CopycatMusic/ComposerMIDICV/docs/pictures/Composer_MIDI_CV_Panel_Silkscreen.png

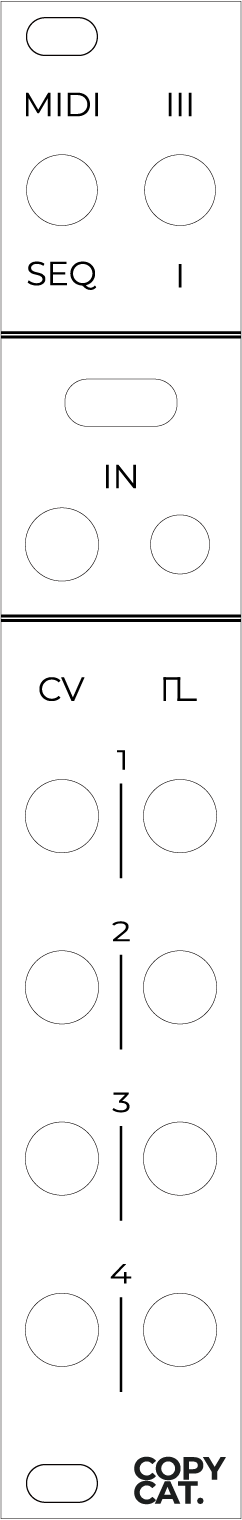
docs/pictures/Composer_MIDI_CV_Panel_Silkscreen.png
