CopycatMusic/ComposerMIDICV/docs/pictures/ComposerBack.png

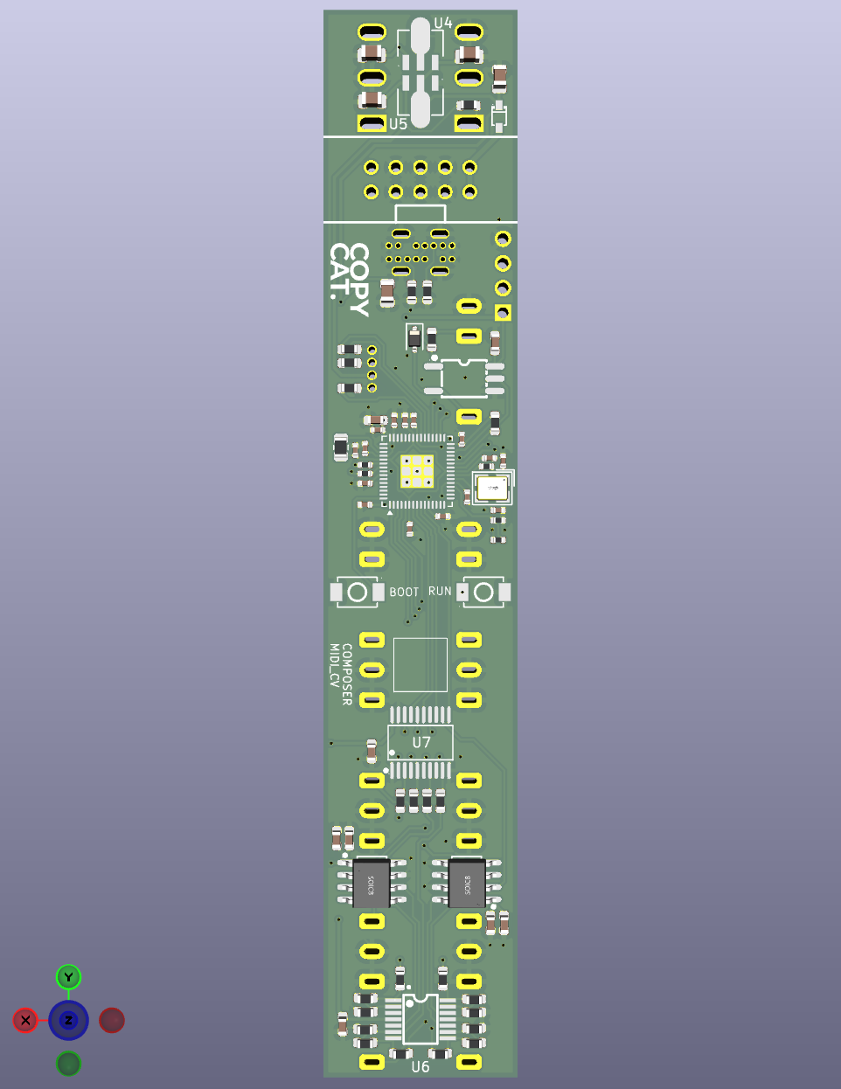
docs/pictures/ComposerBack.png
