CopycatMusic/ComposerMIDICV/hardware/v0.2.1/BOM_V0.2.1_v0.2_1.csv

No. | Quantity | Comment | Designator | Footprint | Value | Manufacturer Part | Manufacturer | Supplier Part | Supplier
1 | 2 | 10uF | C1,C2 | C0805 | 10uF | CL21A106KAYNNNE | SAMSUNG(三星) | C15850 | LCSC
2 | 2 | 15pF | C3,C17 | C0603 | 15pF | CL10C150JB8NNNC | SAMSUNG(三星) | C1644 | LCSC
3 | 15 | 100nF | C4,C5,C6,C7,C10,C11,C12,C13,C15,C16,C19,C20,C21,C22,C24 | C0402 | 100nF | CL05B104KB54PNC | SAMSUNG(三星) | C307331 | LCSC
4 | 3 | 4.7uF | C8,C18,C23 | C0402 | 4.7uF | CL05A475MP5NRNC | SAMSUNG(三星) | C23733 | LCSC
5 | 1 | PH2.54-01-04PZD | H1 | HDR-TH_4P-P2.54-V-M-1 |  | PH2.54-01-04PZD | XUNPU(讯普) | C7501582 | LCSC
6 | 8 | PJ3001F | J1,J2,J3,J4,J5,J6,J7,J8 | AudioJack_3.5mm |  |  | Tayda Electronics
7 | 1 | 3.3uH | L1 | IND-SMD_L2.0-W1.6_AOTA-B201610S3R3-101-T | 3.3uH | AOTA-B201610S3R3-101-T | ABRACON | C42411119 | LCSC
8 | 2 | 5.1kΩ | R1,R2 | R0402 | 5.1kΩ | 0402WGF5101TCE | UNI-ROYAL(厚声) | C25905 | LCSC
9 | 8 | 10kΩ | R3,R18,R19,R20,R22,R23,R24,R25 | R0402 | 10kΩ | 0402WGF1002TCE | UNI-ROYAL(厚声) | C25744 | LCSC
10 | 3 | 33Ω | R4,R5,R17 | R0402 | 33Ω | 0402WGF330JTCE | UNI-ROYAL(厚声) | C25105 | LCSC
11 | 9 | 1kΩ | R6,R7,R8,R9,R10,R11,R12,R13,R16 | R0603 | 1kΩ | 0603WAF1001T5E | UNI-ROYAL(厚声) | C21190 | LCSC
12 | 2 | 470Ω | R14,R15 | R0603 | 470Ω | 0603WAF4700T5E | UNI-ROYAL(厚声) | C23179 | LCSC
13 | 1 | 1kΩ | R21 | R0402 | 1kΩ | 0402WGF1001TCE | UNI-ROYAL(厚声) | C11702 | LCSC
14 | 2 | TS-1088-AR02016 | SW1,SW3 | SW-SMD_L3.9-W3.0-P4.45 |  | TS-1088-AR02016 | XUNPU(讯普) | C720477 | LCSC
15 | 1 | RS-07 300±150gf | SW2 | RS16-Rotary-Switches
16 | 1 | NCP1117ST33T3G | U1 | SOT-223-3_L6.5-W3.4-P2.30-LS7.0-BR |  | NCP1117ST33T3G | onsemi(安森美) | C26537 | LCSC
17 | 1 | TYPE-C 14PLC-H10.0 | U2 | USB-C-TH_SHOUHAN_TYPE-C-14PLC-H10.0 |  | TYPE-C 14PLC-H10.0 | SHOU HAN(首韩) | C3151746 | LCSC
18 | 1 | RP2354A | U3 | QFN-60_L7.0-W7.0-P0.40-TL-EP3.4 |  | RP2354A | Raspberry Pi(树莓派) | C41378174 | LCSC
19 | 1 | 12MHz | U4 | CRYSTAL-SMD_4P-L3.2-W2.5-BL | 12MHz | ABM8-272-T3 | ABRACON | C20625731 | LCSC
20 | 2 | MCP4822-E/SN | U5,U6 | SOIC-8_L4.9-W3.9-P1.27-LS6.0-BL |  | MCP4822-E/SN | MICROCHIP(美国微芯) | C16040 | LCSC
21 | 1 | 74AHCT244PW | U7 | TSSOP-20_L6.5-W4.4-P0.65-LS6.4-BL |  | 74AHCT244PW | MDD(辰达半导体) | C54815894 | LCSC
22 | 1 | TLV9064IPWR | U8 | TSSOP-14_L5.0-W4.4-P0.65-LS6.4-BL |  | TLV9064IPWR | TI(德州仪器) | C779410 | LCSC
23 | 1 | TJ-L5FPTXHMCYLCRGB-A5 | U9 | LED-TH_4P-BD5.8-P1.30 |  | TJ-L5FPTXHMCYLCRGB-A5 | TOGIALED(统佳) | C20613339 | LCSC
