CopycatMusic/ComposerMIDICV/hardware/ComposerMIDICV/production/COMPOSERv1.0_bom.csv

Designator | Footprint | Quantity | Value | LCSC Part #
C1 | C_0805 | 1 | 1uF | C28323
C10, C11, C12, C13, C14, C15, C2, C5, C6, C7, C8, C9 | C_0402 | 12 | 100nF | C1525
C16, C21 | C_0805 | 2 | 10uF | C15850
C17 | C_0402 | 1 | 4.7uF | C23733
C18, C26, C29, C31, C33 | C_0603 | 5 | 100nF | C14663
C19 | C_0805 | 1 | 4.7uF | C1779
C20 | C_0805 | 1 | 100nF | C28233
C27, C28 | C_0603 | 2 | 10uF | C96446
C3, C4 | C_0402 | 2 | 15pF | C1548
C32 | C_0603 | 1 | 4.7uF | C19666
D1 | SOD-323_L1.8-W1.3-LS2.5-RD | 1 | 1N5819WS | C191023
D2 | D_SOD-323 | 1 | 1N4148WS | C2128
H1 | HDR-TH_4P-P2.54-V-M-1 | 1 | PH2.54-01-04PZD | C7501582
J1, J2, J3, J4, J5, J6, J7, J8 | Jack_3.5mm_QingPu_WQP-PJ301M-12_Vertical | 8 | AudioJack2_SwitchT
J9 | Jack_3.5mm_QingPu_WQP-PJ366ST_Vertical | 1 | AudioJack3
L3 | 0805 | 1 | 3.3uH | AOTA-B201610S3R3-101-T
P1 | IDC-TH_10P-P2.54_C5665 | 1 | HDR-IDC-2.54-2X5P | C5665
R1 | R_0402 | 1 | 1kΩ | C11702
R10, R11, R12, R13, R14, R15, R16, R17, R8, R9 | R_0603 | 10 | 1kΩ | C21190
R18 | R_0603 | 1 | 220Ω | C22962
R19, R20 | R_0402 | 2 | 100kΩ | C25741
R2, R3 | R_0402 | 2 | 33Ω | C25105
R21, R22, R23, R24, R25, R26, R27, R28, R29, R7 | R_0603 | 10 | 10kΩ | C25804
R4 | R_0603 | 1 | 470Ω | C23179
R5, R6 | R_0603 | 2 | 5.1kΩ | C23186
SW1, SW2 | SW-SMD_L3.9-W3.0-P4.45 | 2 | TS-1088-AR02016 | C720477
SW3 | SW-TH_MT-0-103-A101-M200-RS | 1 | MT-0-102-A101-M200-RS+PJ | C1788492
SW4 | SW-TH_MT-0-103-A101-M200-RS | 1 | MT-0-103-A101-M200-RS+PJ | C1788493
U1 | QFN-60-1EP_7x7mm_P0.4mm_EP3.4x3.4mm | 1 | RP2354A
U10 | USB-C-TH_SHOUHAN_TYPE-C-14PLC-H10.0 | 1 | TYPE-C 14PLC-H10.0 | C3151746
U11 | OPTO-SMD-5_L3.7-W4.6-P1.27-LS7.0-BR | 1 | TLP2361 | C107626
U2 | CRYSTAL-SMD_4P-L3.2-W2.5-BL | 1 | ABM8-272-T3_C20625731 | C20625731
U3 | LED-TH_4P-BD5.8-P1.30 | 1 | TJ-L5FPTXHMCYLCRGB-A5 | C20613339
U4 | SOT-89-3_L4.5-W2.5-P1.50-LS4.2-BR | 1 | 78L05G-AB3-R | C71136
U5 | SOT-89-3_L4.5-W2.5-P1.50-LS4.2-BR | 1 | HT7533-1_C14289 | C14289
U6 | TSSOP-14_L5.0-W4.4-P0.65-LS6.4-BL | 1 | OPA4991IPWR | C2873620
U7 | TSSOP-20_L6.5-W4.4-P0.65-LS6.4-BL | 1 | 74AHCT244PW | C54815894
U8, U9 | SOIC-8_L4.9-W3.9-P1.27-LS6.0-BL | 2 | MCP4822-E/SN | C16040
