CopycatMusic/ComposerMIDICV/docs/Schematic.pdf

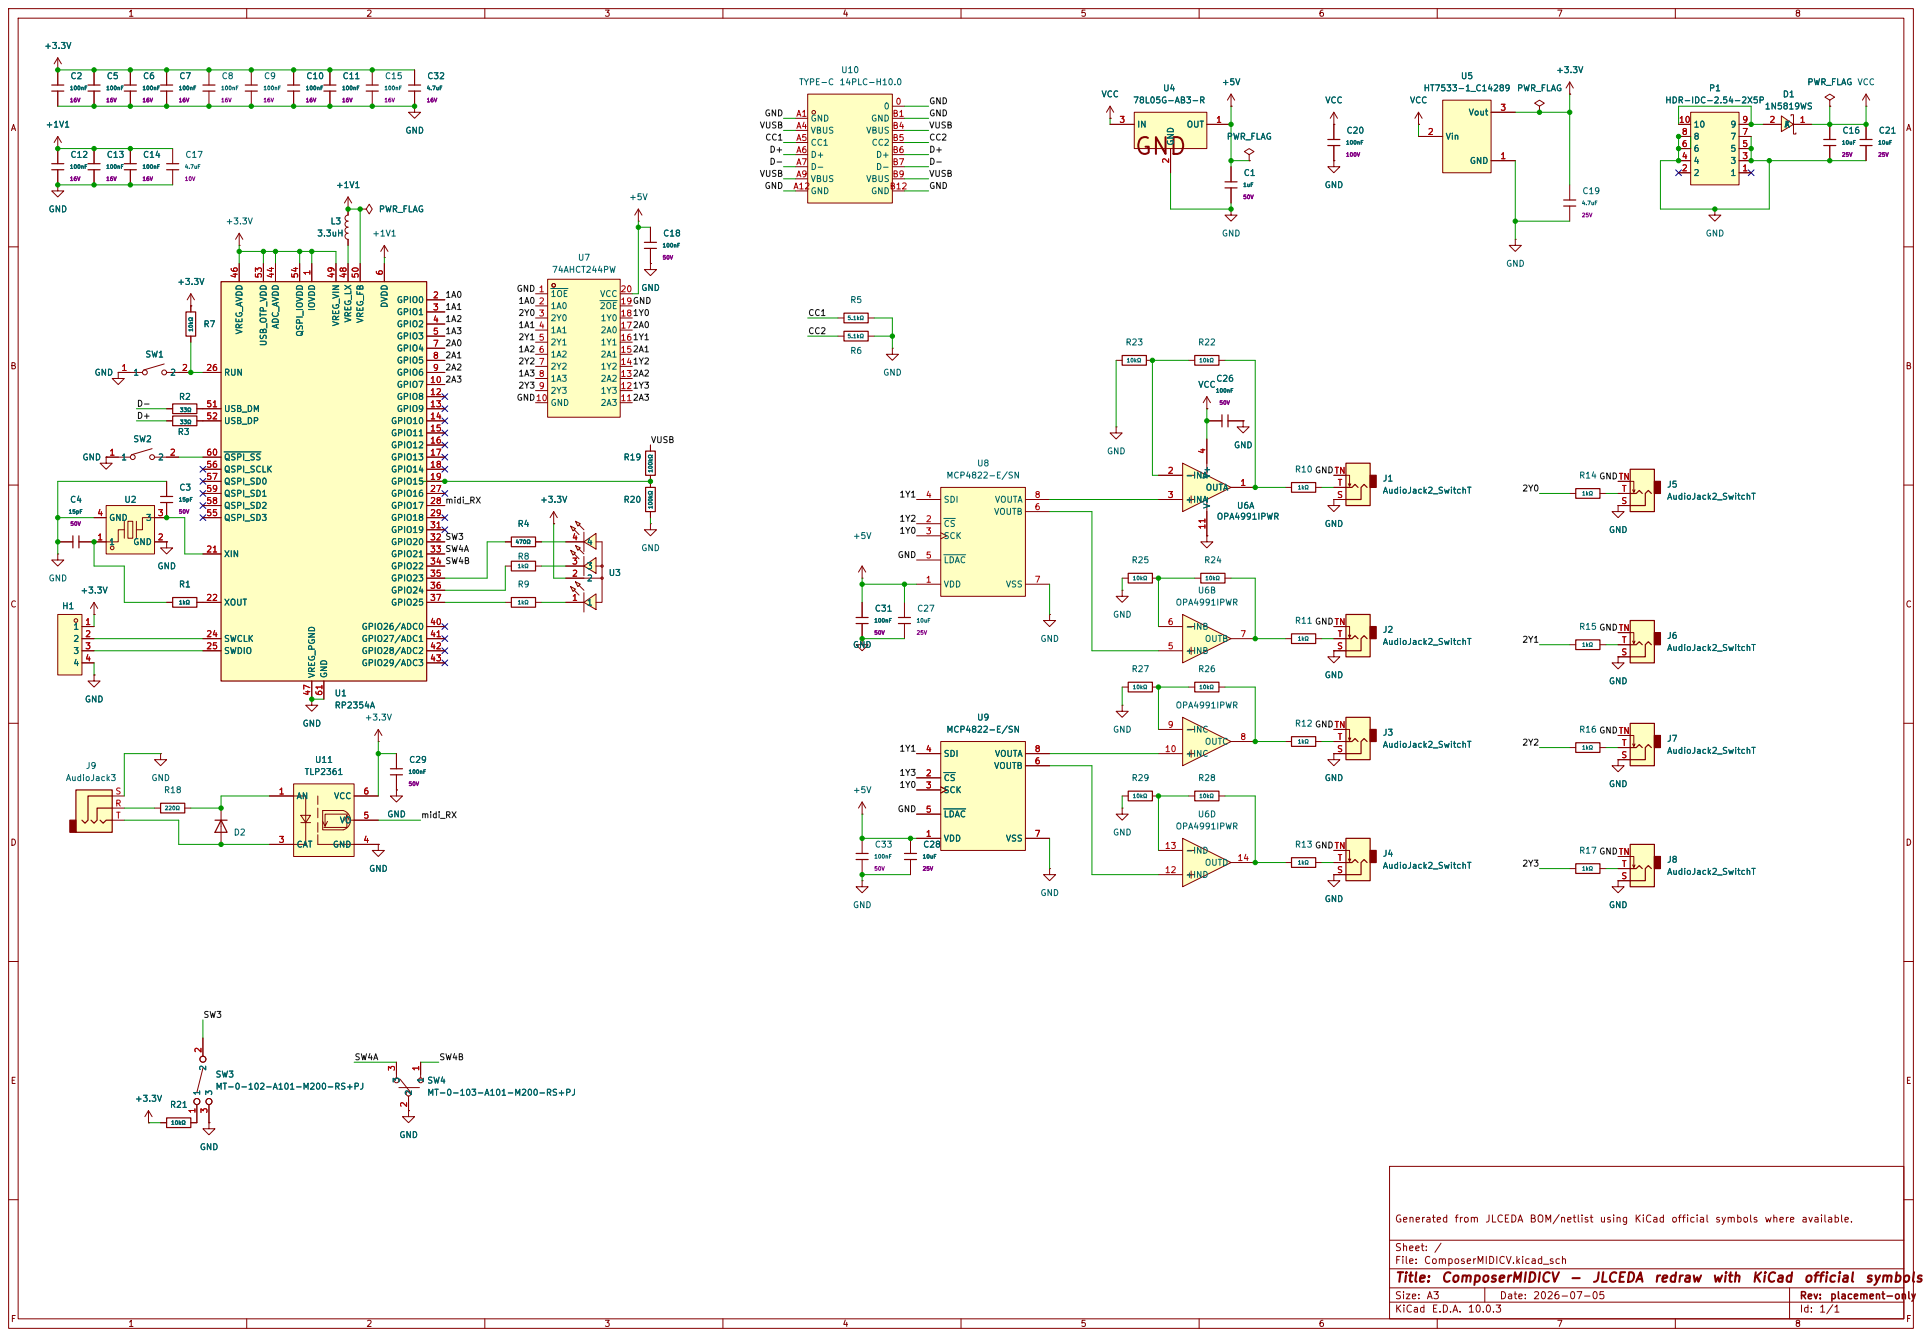
[picture p3: page 1]

6 6 | 5 5
4 4 | 3 3
2 2 | 1 1

Generated from JLCEDA BOM/netlist using KiCad official symbols where available. DVDD

SW4 MT-0-103-A101-M200-RS+PJ GND

Sheet: /
File: ComposerMIDICV.kicad_sch
Title: ComposerMIDICV - JLCEDA redraw with KiCad official symbols

F Date: 2026-07-05

KiCad E.D.A. 10.0.3 | Id: 1/1
