CopycatMusic/ComposerMIDICV/hardware/v0.2.1/Schematicv0.2.1.pdf

# VBUS 11 4

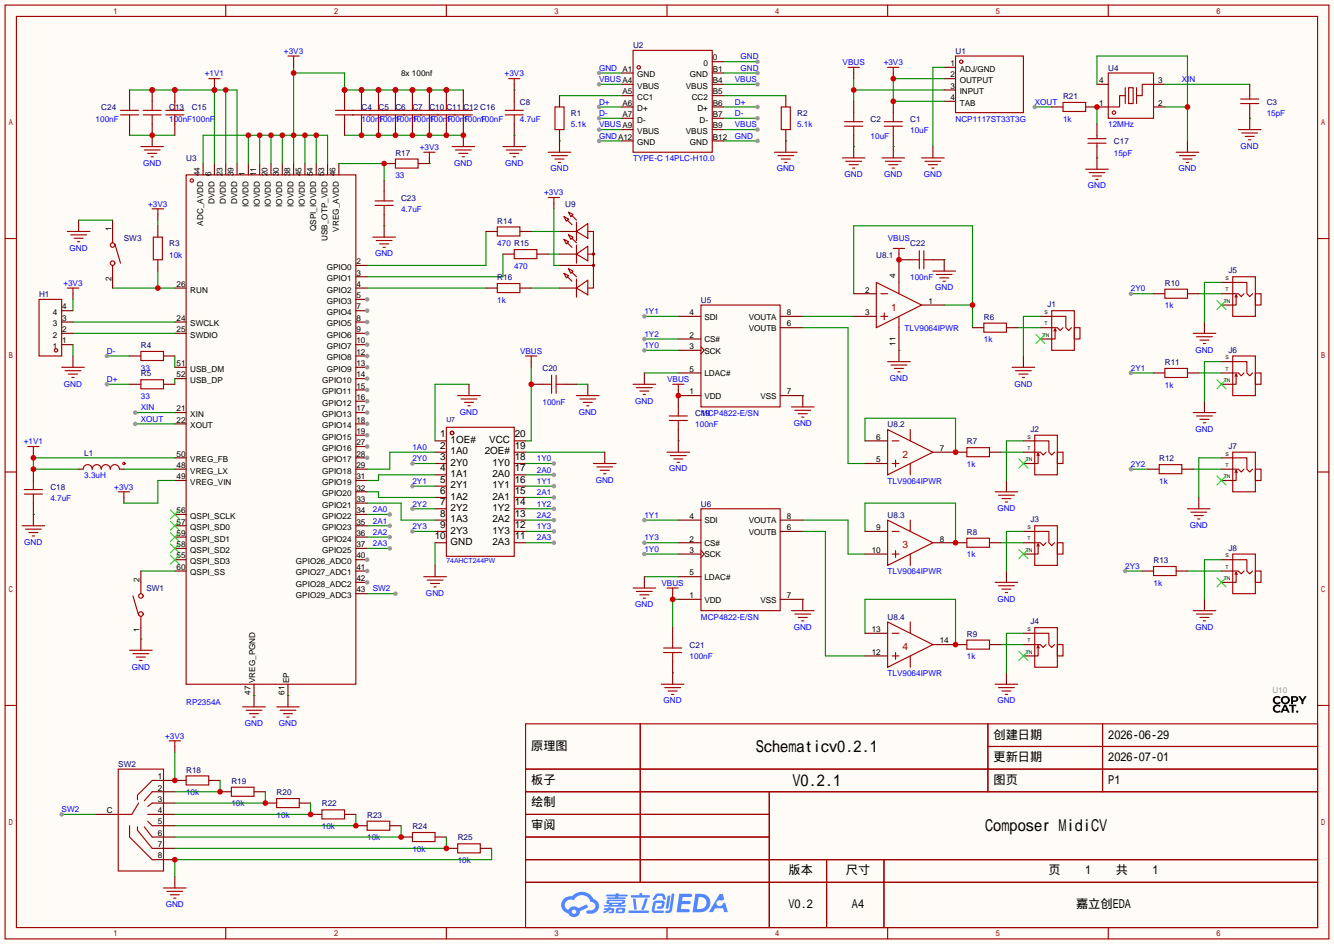
[picture p4: page 1]

C4 | C5 | C6 | C7 | C10 | C11
100nF | 100nF | 100nF | 100nF | 100nF | 100nF

原理图 | Schematicv0.2.1 | 创建日期 | 2026-06-29

更新日期 | 2026-07-01

绘制 | | Composer MidiCV
审阅

V0.2 | A4 | 嘉立创EDA
