CopycatMusic/ComposerMIDICV/hardware/legacy/v0.1/Schematicv0.1.pdf

# VBUS 11 4

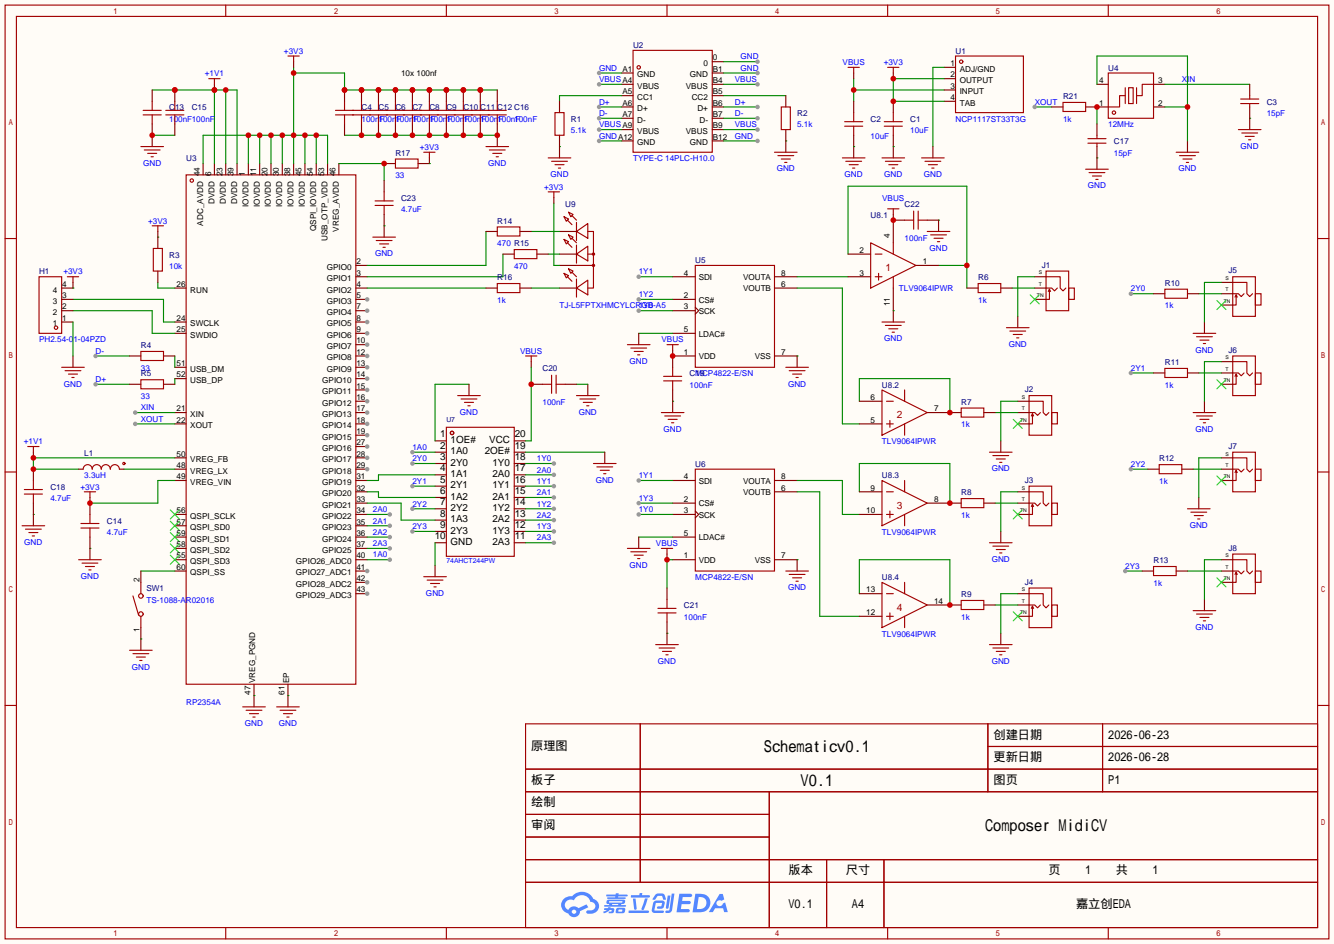
[picture p9: page 1]

C4 | C5 | C6 | C7 | C8 | C9 | C10 | C11
100nF | 100nF | 100nF | 100nF | 100nF | 100nF | 100nF

原理图 | Schematicv0.1 | 创建日期 | 2026-06-23

更新日期 | 2026-06-28

绘制 | | Composer MidiCV
审阅

V0.1 | A4 | 嘉立创EDA
