CopycatMusic/ComposerMIDICV/hardware/ComposerMIDICV/ComposerMIDICV.kicad_pcb

## KiCad design hardware/ComposerMIDICV/ComposerMIDICV.kicad_pcb (2026-10-14)

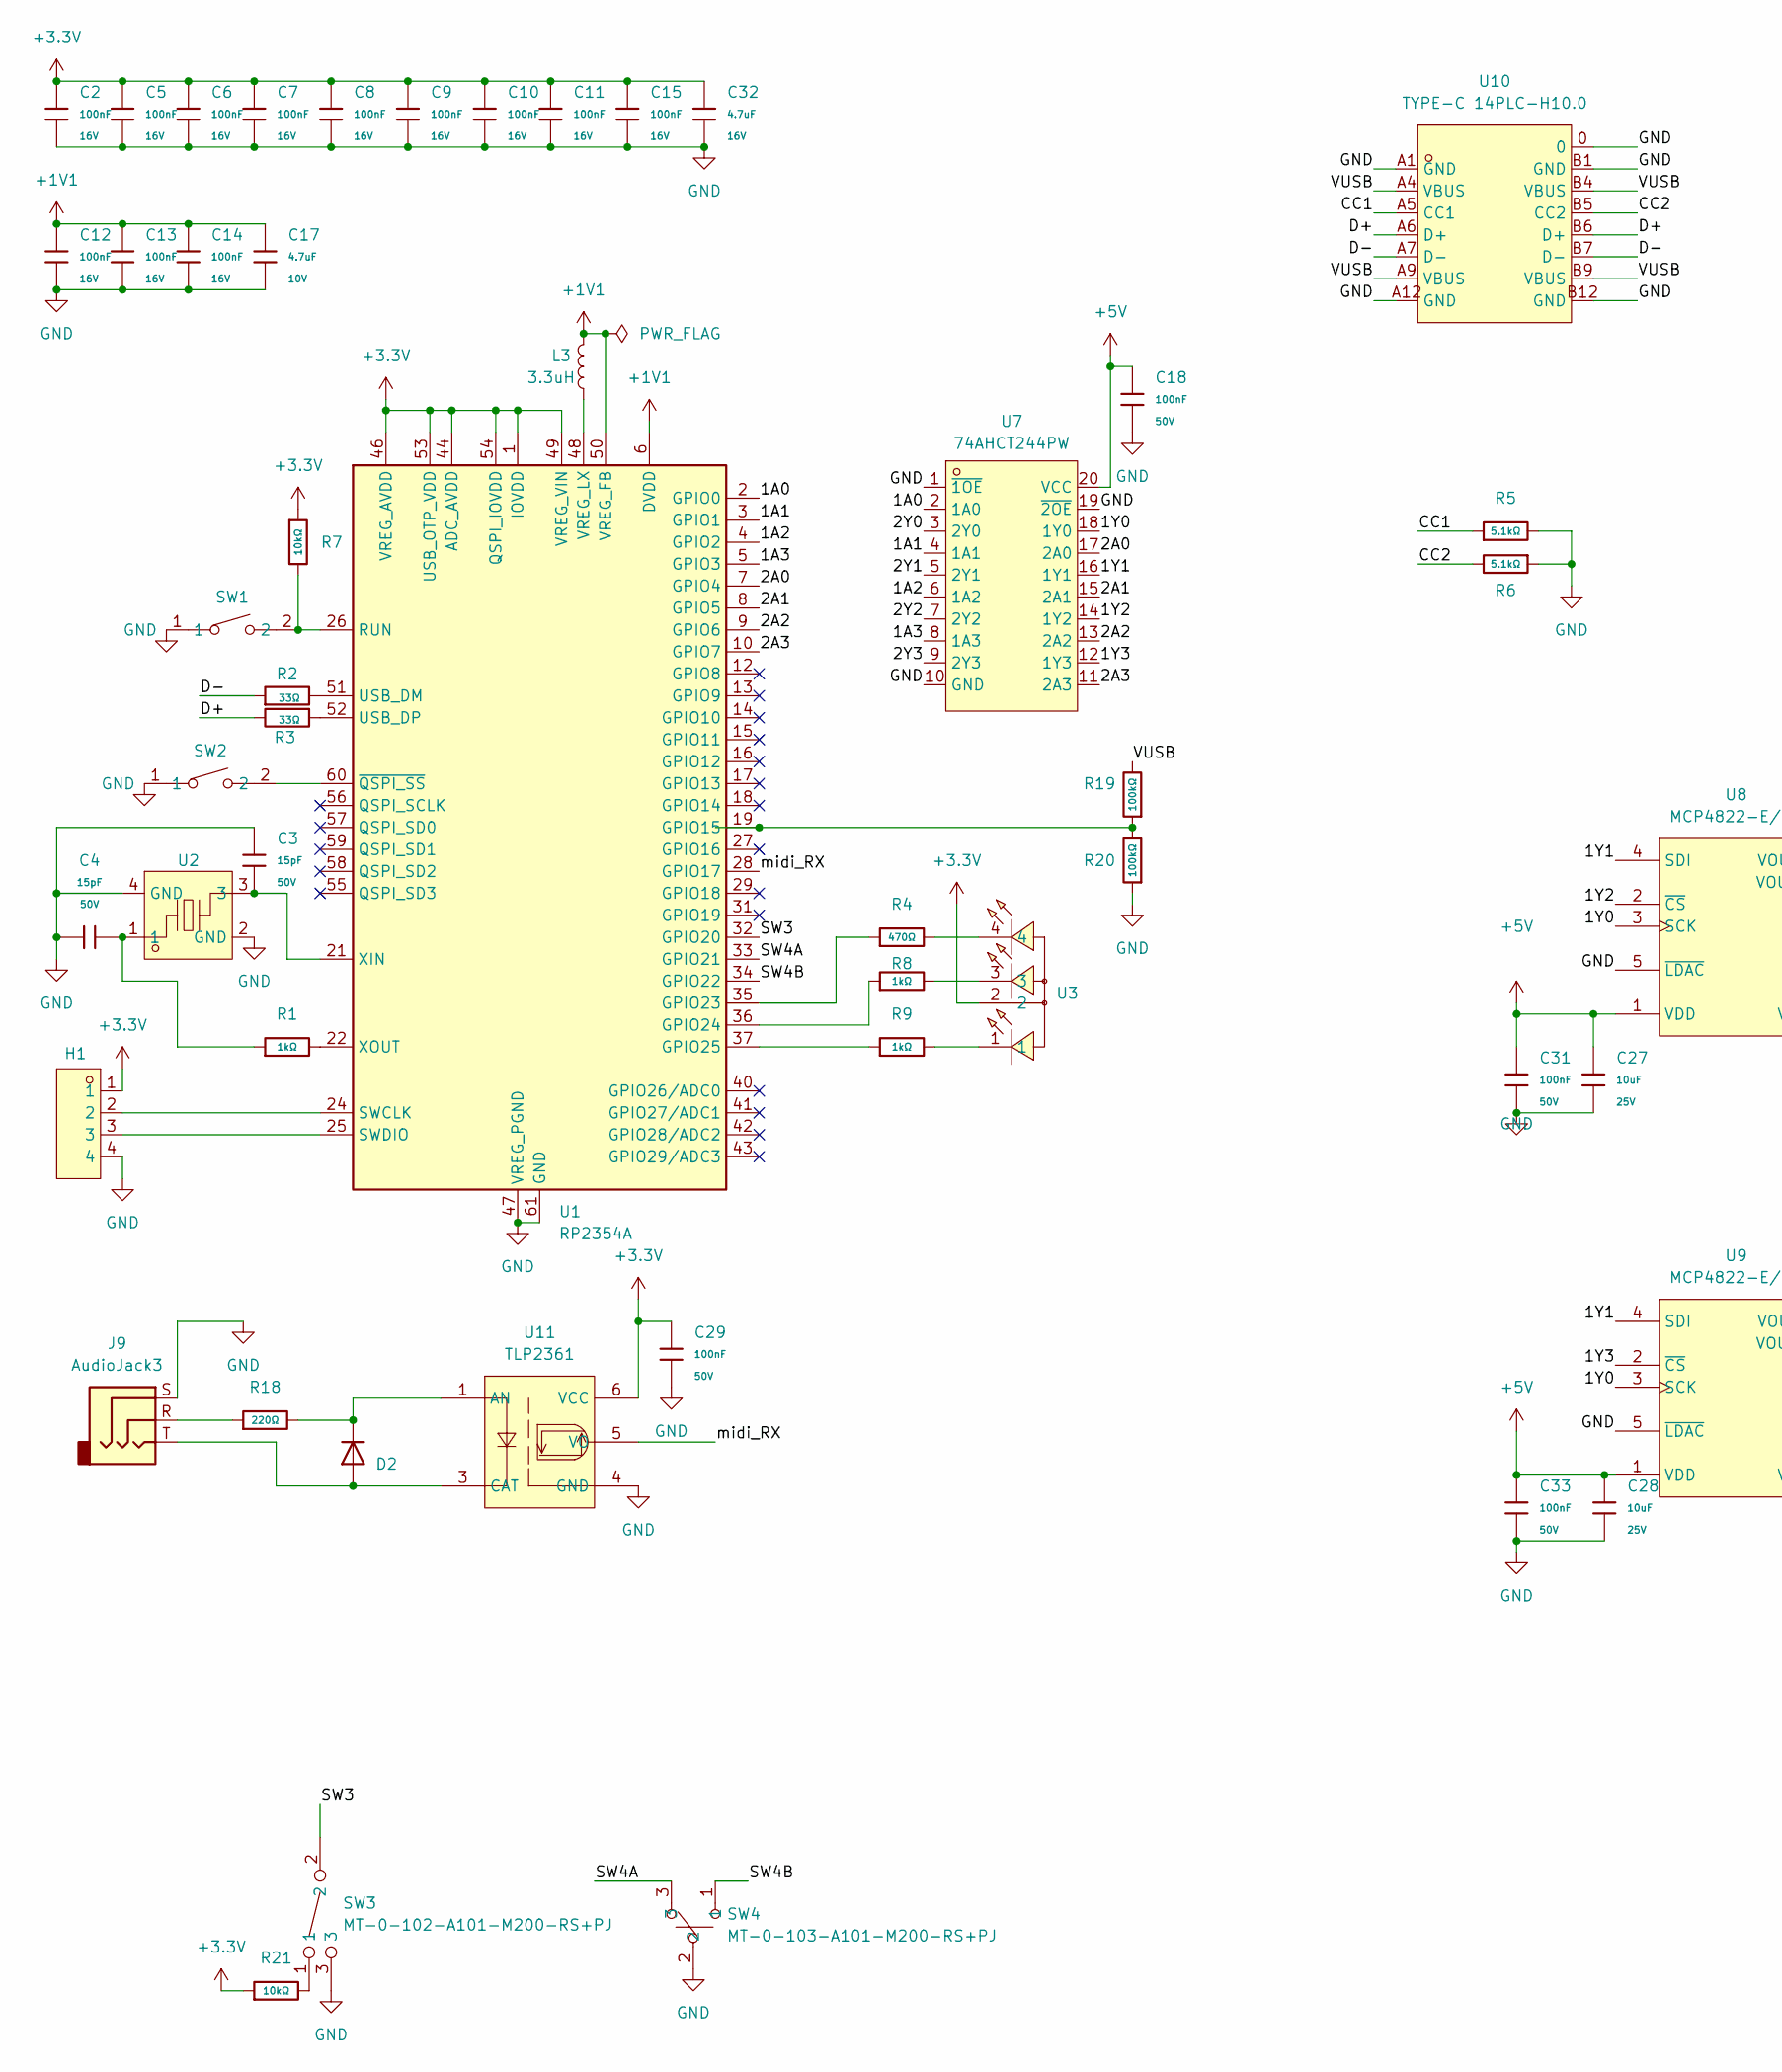
[picture p10: schematic ComposerMIDICV.kicad_sch, ComposerMIDICV - JLCEDA redraw with KiCad official symbols, part in row 1, column 1]

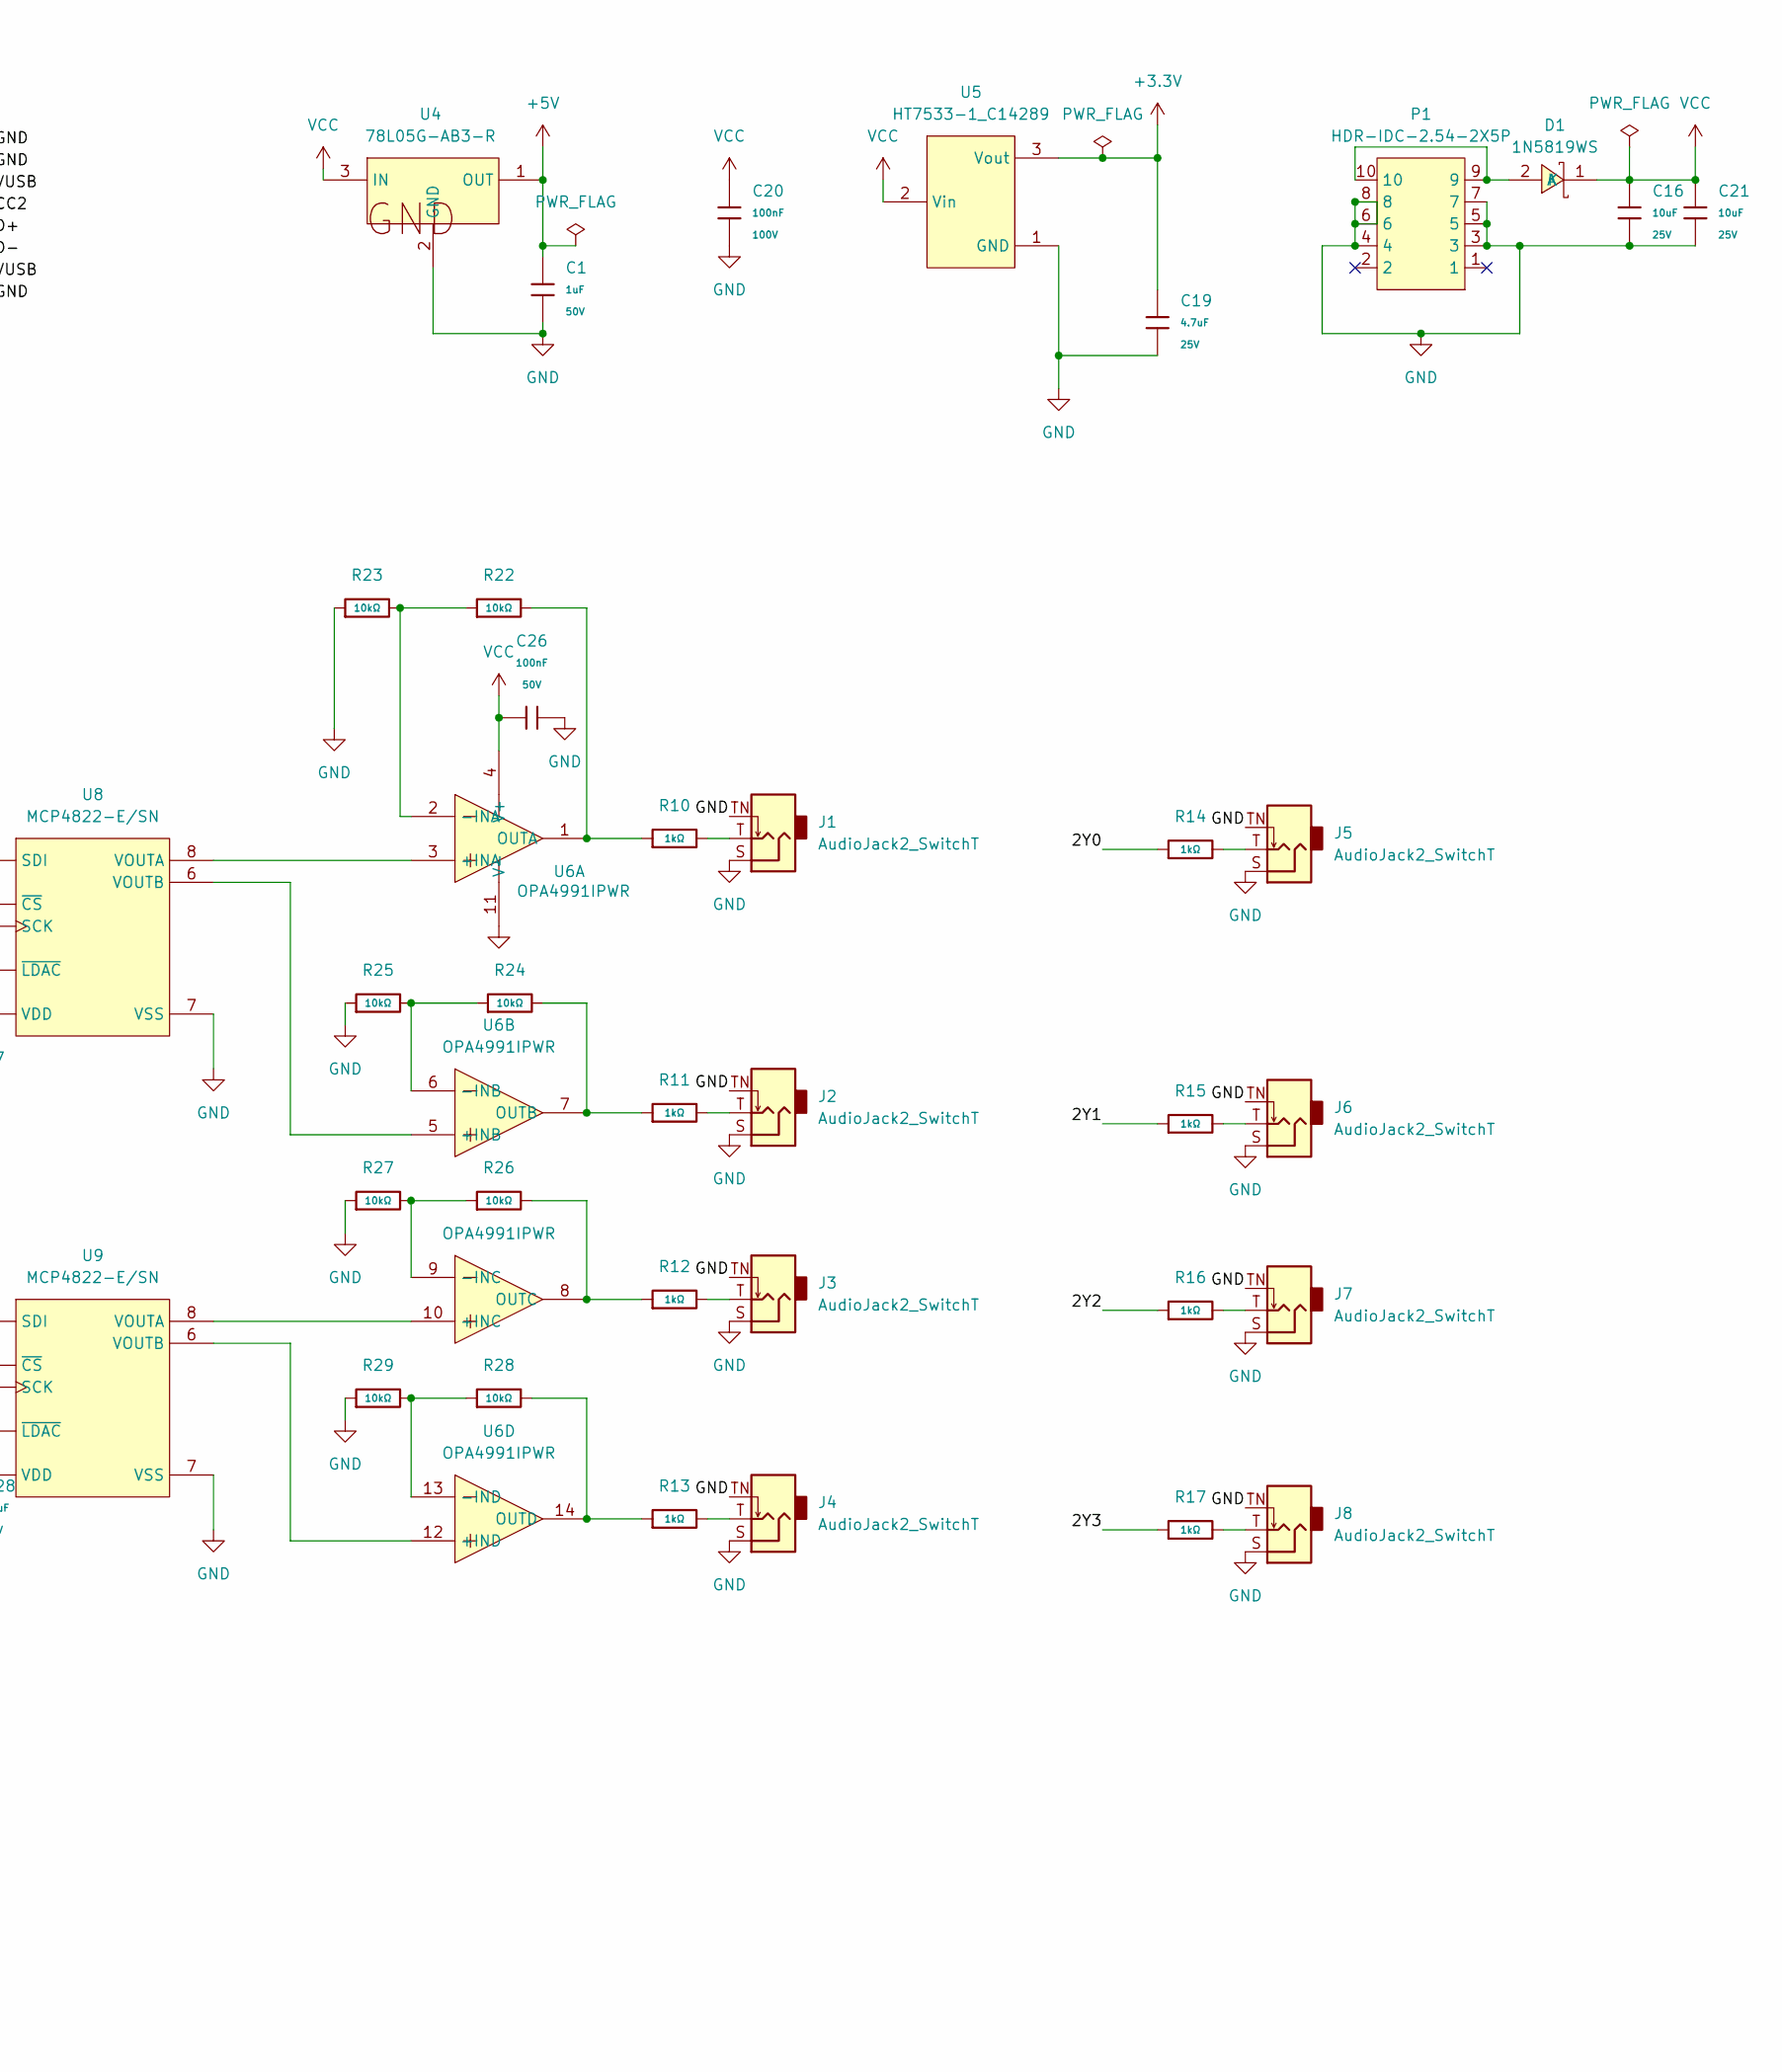
[picture p11: schematic ComposerMIDICV.kicad_sch, ComposerMIDICV - JLCEDA redraw with KiCad official symbols, part in row 1, column 2]

Parts:
C1: 1uF; C_0805; Voltage Rated 50V; Tolerance ±10%; Part CL21B105KBFNNNE; LCSC C28323
C2, C5, C6, C7, C8, C9, C10, C11, C12, C13, C14, C15: 100nF; C_0402; Voltage Rated 16V; Tolerance ±10%; Part CL05B104KO5NNNC; LCSC C1525
C3, C4: 15pF; C_0402; Voltage Rated 50V; Tolerance ±5%; Part 0402CG150J500NT; LCSC C1548
C16, C21: 10uF; C_0805; Voltage Rated 25V; Tolerance ±10%; Part CL21A106KAYNNNE; LCSC C15850
C17: 4.7uF; C_0402; Voltage Rated 10V; Tolerance ±20%; Part CL05A475MP5NRNC; LCSC C23733
C18, C26, C29, C31, C33: 100nF; C_0603; Voltage Rated 50V; Tolerance ±10%; Part CC0603KRX7R9BB104; LCSC C14663
C19: 4.7uF; C_0805; Voltage Rated 25V; Tolerance ±10%; Part CL21A475KAQNNNE; LCSC C1779
C20: 100nF; C_0805; Voltage Rated 100V; Tolerance ±10%; Part CL21B104KCFNNNE; LCSC C28233
C27, C28: 10uF; C_0603; Voltage Rated 25V; Tolerance ±20%; Part CL10A106MA8NRNC; LCSC C96446
C32: 4.7uF; C_0603; Voltage Rated 16V; Tolerance ±10%; Part CL10A475KO8NNNC; LCSC C19666
D1: 1N5819WS; SOD-323_L1.8-W1.3-LS2.5-RD; MPN 1N5819WS; LCSC Part C191023
D2: 1N4148WS; D_SOD-323; Forward Voltage (Vf@If) 1.25V@150mA; Reverse Voltage (Vr) 100V; Part 1N4148WS; LCSC C2128
H1: PH2.54-01-04PZD; HDR-TH_4P-P2.54-V-M-1; MPN PH2.54-01-04PZD; LCSC Part C7501582
J1, J2, J3, J4, J5, J6, J7, J8: AudioJack2_SwitchT; Jack_3.5mm_QingPu_WQP-PJ301M-12_Vertical
J9: AudioJack3; Jack_3.5mm_QingPu_WQP-PJ366ST_Vertical
L3: 3.3uH; R_0805_2012Metric; MPN AOTA-B201610S3R3-101-T
P1: HDR-IDC-2.54-2X5P; IDC-TH_10P-P2.54_C5665; MPN 2.54-2*5P简牛; LCSC Part C5665
R1: 1kΩ; R_0402; Overload Voltage (Max) 50V; Tolerance ±1%; Part 0402WGF1001TCE; LCSC C11702
R2, R3: 33Ω; R_0402; Overload Voltage (Max) 50V; Tolerance ±1%; Part 0402WGF330JTCE; LCSC C25105
R4: 470Ω; R_0603; Overload Voltage (Max) 75V; Tolerance ±1%; Part 0603WAF4700T5E; LCSC C23179
R5, R6: 5.1kΩ; R_0603; Overload Voltage (Max) 75V; Tolerance ±1%; Part 0603WAF5101T5E; LCSC C23186
R7, R21, R22, R23, R24, R25, R26, R27, R28, R29: 10kΩ; R_0603; Overload Voltage (Max) 75V; Tolerance ±1%; Part 0603WAF1002T5E; LCSC C25804
R8, R9, R10, R11, R12, R13, R14, R15, R16, R17: 1kΩ; R_0603; Overload Voltage (Max) 75V; Tolerance ±1%; Part 0603WAF1001T5E; LCSC C21190
R18: 220Ω; R_0603; Overload Voltage (Max) 75V; Tolerance ±1%; Part 0603WAF2200T5E; LCSC C22962
R19, R20: 100kΩ; R_0402; Overload Voltage (Max) 50V; Tolerance ±1%; Part 0402WGF1003TCE; LCSC C25741
SW1, SW2: TS-1088-AR02016; SW-SMD_L3.9-W3.0-P4.45; MPN TS-1088-AR02016; LCSC Part C720477
SW3: MT-0-102-A101-M200-RS+PJ; SW-TH_MT-0-103-A101-M200-RS; MPN MT-0-102-A101-M200-RS; LCSC Part C1788492
SW4: MT-0-103-A101-M200-RS+PJ; SW-TH_MT-0-103-A101-M200-RS; MPN MT-0-103-A101-M200-RS; LCSC Part C1788493
U1: RP2354A; QFN-60-1EP_7x7mm_P0.4mm_EP3.4x3.4mm
U2: ABM8-272-T3_C20625731; CRYSTAL-SMD_4P-L3.2-W2.5-BL; MPN ABM8-272-T3; LCSC Part C20625731
U3: TJ-L5FPTXHMCYLCRGB-A5; LED-TH_4P-BD5.8-P1.30; MPN TJ-L5FPTXHMCYLCRGB-A5; LCSC Part C20613339
U4: 78L05G-AB3-R; SOT-89-3_L4.5-W2.5-P1.50-LS4.2-BR; MPN 78L05G-AB3-R; LCSC Part C71136
U5: HT7533-1_C14289; SOT-89-3_L4.5-W2.5-P1.50-LS4.2-BR; MPN HT7533-1; LCSC Part C14289
U6: OPA4991IPWR; TSSOP-14_L5.0-W4.4-P0.65-LS6.4-BL; MPN OPA4991IPWR; LCSC Part C2873620
U7: 74AHCT244PW; TSSOP-20_L6.5-W4.4-P0.65-LS6.4-BL; MPN 74AHCT244PW; LCSC Part C54815894
U8, U9: MCP4822-E/SN; SOIC-8_L4.9-W3.9-P1.27-LS6.0-BL; MPN MCP4822-E/SN; LCSC Part C16040
U10: TYPE-C 14PLC-H10.0; USB-C-TH_SHOUHAN_TYPE-C-14PLC-H10.0; MPN TYPE-C 14PLC-H10.0; LCSC Part C3151746
U11: TLP2361; OPTO-SMD-5_L3.7-W4.6-P1.27-LS7.0-BR; MPN TLP2361(TPL,E; LCSC Part C107626

Connections:
+1V1: C12.1, C13.1, C14.1, C17.1, L3.2, U1.6 (DVDD), U1.23 (DVDD), U1.39 (DVDD), U1.50 (VREG_FB)
+3.3V: C2.1, C5.1, C6.1, C7.1, C8.1, C9.1, C10.1, C11.1, C15.1, C19.1, C29.1, C32.1, H1.1, R7.1, R21.1, U1.1 (IOVDD), U1.11 (IOVDD), U1.20 (IOVDD), U1.30 (IOVDD), U1.38 (IOVDD), U1.44 (ADC_AVDD), U1.45 (IOVDD), U1.46 (VREG_AVDD), U1.49 (VREG_VIN), U1.53 (USB_OTP_VDD), U1.54 (QSPI_IOVDD), U3.2, U5.3 (Vout), U11.6 (VCC)
+5V: C1.1, C18.1, C27.1, C28.1, C31.1, C33.1, U4.1 (OUT), U7.20 (VCC), U8.1 (VDD), U9.1 (VDD)
/1A0: U1.2 (GPIO0), U7.2 (1A0)
/1A1: U1.3 (GPIO1), U7.4 (1A1)
/1A2: U1.4 (GPIO2), U7.6 (1A2)
/1A3: U1.5 (GPIO3), U7.8 (1A3)
/1Y0: U7.18 (1Y0), U8.3 (SCK), U9.3 (SCK)
/1Y1: U7.16 (1Y1), U8.4 (SDI), U9.4 (SDI)
/1Y2: U7.14 (1Y2), U8.2 (~CS)
/1Y3: U7.12 (1Y3), U9.2 (~CS)
/2A0: U1.7 (GPIO4), U7.17 (2A0)
/2A1: U1.8 (GPIO5), U7.15 (2A1)
/2A2: U1.9 (GPIO6), U7.13 (2A2)
/2A3: U1.10 (GPIO7), U7.11 (2A3)
/2Y0: R14.1, U7.3 (2Y0)
/2Y1: R15.1, U7.5 (2Y1)
/2Y2: R16.1, U7.7 (2Y2)
/2Y3: R17.1, U7.9 (2Y3)
/CC1: R5.1, U10.A5 (CC1)
/CC2: R6.2, U10.B5 (CC2)
/D+: R3.2, U10.A6 (D+), U10.B6 (D+)
/D-: R2.1, U10.A7 (D-), U10.B7 (D-)
/SW3: SW3.2, U1.32 (GPIO20)
/SW4A: SW4.3, U1.33 (GPIO21)
/SW4B: SW4.1, U1.34 (GPIO22)
/VUSB: R19.2, U10.A4 (VBUS), U10.A9 (VBUS), U10.B4 (VBUS), U10.B9 (VBUS)
/midi_RX: U1.28 (GPIO17), U11.5 (VO)
GND: C1.2, C2.2, C3.1, C4.1, C5.2, C6.2, C7.2, C8.2, C9.2, C10.2, C11.2, C12.2, C13.2, C14.2, C15.2, C16.2, C17.2, C18.2, C19.2, C20.2, C21.2, C26.2, C27.2, C28.2, C29.2, C31.2, C32.2, C33.2, H1.4, J1.S, J1.TN, J2.S, J2.TN, J3.S, J3.TN, J4.S, J4.TN, J5.S, J5.TN, J6.S, J6.TN, J7.S, J7.TN, J8.S, J8.TN, J9.S, P1.3, P1.4, P1.5, P1.6, P1.7, P1.8, R5.2, R6.1, R20.1, R23.1, R25.1, R27.1, R29.1, SW1.1, SW2.1, SW3.3, SW4.2, U1.47 (VREG_PGND), U1.61 (GND), U2.2 (GND), U2.4 (GND), U4.2 (GND), U5.1 (GND), U6.11 (V-), U7.1 (~1OE), U7.10 (GND), U7.19 (~2OE), U8.5 (~LDAC), U8.7 (VSS), U9.5 (~LDAC), U9.7 (VSS), U10.0, U10.A1 (GND), U10.A12 (GND), U10.B1 (GND), U10.B12 (GND), U11.4 (GND)
unnamed: C4.2, R1.1, U2.1
unnamed: D1.2 (A), P1.9, P1.10
unnamed: J1.T, R10.2
unnamed: J2.T, R11.2
unnamed: J3.T, R12.2
unnamed: J4.T, R13.2
unnamed: J5.T, R14.2
unnamed: J6.T, R15.2
unnamed: J7.T, R16.2
unnamed: J8.T, R17.2
unnamed: J9.R, R18.1
unnamed: R4.2, U3.4
unnamed: R8.2, U3.3
unnamed: R9.2, U3.1
unnamed: R21.2, SW3.1
unnamed: R19.1, R20.2, U1.19 (GPIO15)
unnamed: R4.1, U1.35 (GPIO23)
unnamed: R8.1, U1.36 (GPIO24)
unnamed: R9.1, U1.37 (GPIO25)
unnamed: R7.2, SW1.2, U1.26 (RUN)
unnamed: H1.2, U1.24 (SWCLK)
unnamed: H1.3, U1.25 (SWDIO)
unnamed: R2.2, U1.51 (USB_DM)
unnamed: R3.1, U1.52 (USB_DP)
unnamed: L3.1, U1.48 (VREG_LX)
unnamed: C3.2, U1.21 (XIN), U2.3
unnamed: R1.2, U1.22 (XOUT)
unnamed: SW2.2, U1.60 (~QSPI_SS)
unnamed: U6.3 (+INA), U8.8 (VOUTA)
unnamed: R22.1, R23.2, U6.2 (-INA)
unnamed: R10.1, R22.2, U6.1 (OUTA)
unnamed: U6.5 (+INB), U8.6 (VOUTB)
unnamed: R24.1, R25.2, U6.6 (-INB)
unnamed: R11.1, R24.2, U6.7 (OUTB)
unnamed: U6.10 (+INC), U9.8 (VOUTA)
unnamed: R26.1, R27.2, U6.9 (-INC)
unnamed: R12.1, R26.2, U6.8 (OUTC)
unnamed: U6.12 (+IND), U9.6 (VOUTB)
unnamed: R28.1, R29.2, U6.13 (-IND)
unnamed: R13.1, R28.2, U6.14 (OUTD)
unnamed: D2.1, R18.2, U11.1 (AN)
unnamed: D2.2, J9.T, U11.3 (CAT)
VCC: C16.1, C20.1, C21.1, C26.1, D1.1 (K), U4.3 (IN), U5.2 (Vin), U6.4 (V+)

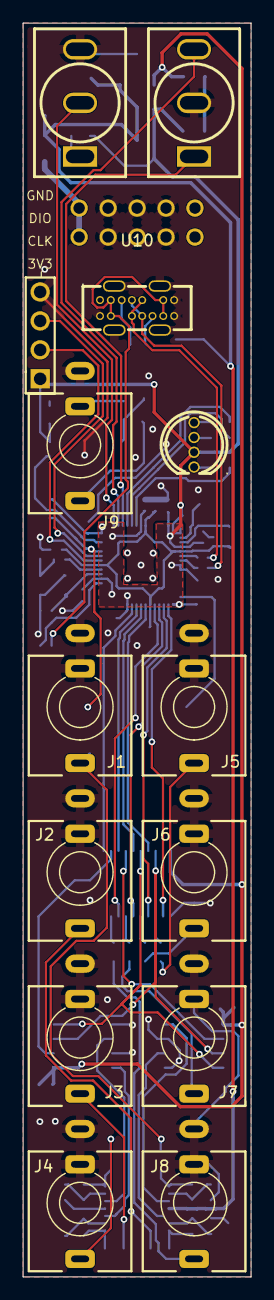
[picture p12: board ComposerMIDICV.kicad_pcb from above]

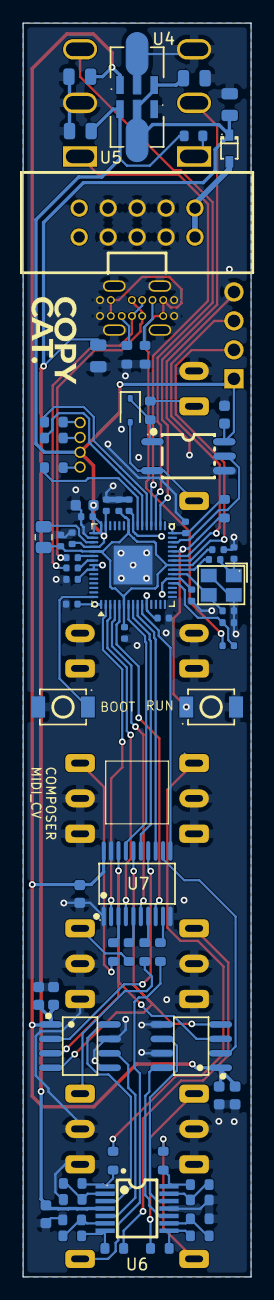
[picture p13: board ComposerMIDICV.kicad_pcb from below]

Board: 2 copper layers, 20.0 x 110.0 mm, 86 parts (72 on the bottom side), 72 nets.
