CopycatMusic/ComposerMIDICV/(commit log)

2026-07-01 Initial commit: Composer MIDICV firmware, hardware designs, and tests
    [BOM_V0.2.1_v0.2_1.csv, PickAndPlace_v0_2_1.csv]
2026-10-14 Prepare Composer MIDICV v1.0 hardware, firmware and documentation for public sharing
    [BOM_V0.2.1_v0.2_1.csv, COMPOSERv0.3_bom.csv, COMPOSERv0.3_designators.csv, COMPOSERv0.3_positions.csv, COMPOSERv1.0_bom.csv, COMPOSERv1.0_designators.csv, COMPOSERv1.0_positions.csv, ComposerMIDICV.kicad_pcb]
2026-10-28 Add prototype image
